crazyrat-software/Emulator-EPROM/(list of files, drawings)

Other design files:
device/EE89.PCB
device/EE89_2.PCB
device/FRONT.PCB
